mitchsf/Zev/Zev-1.JPG

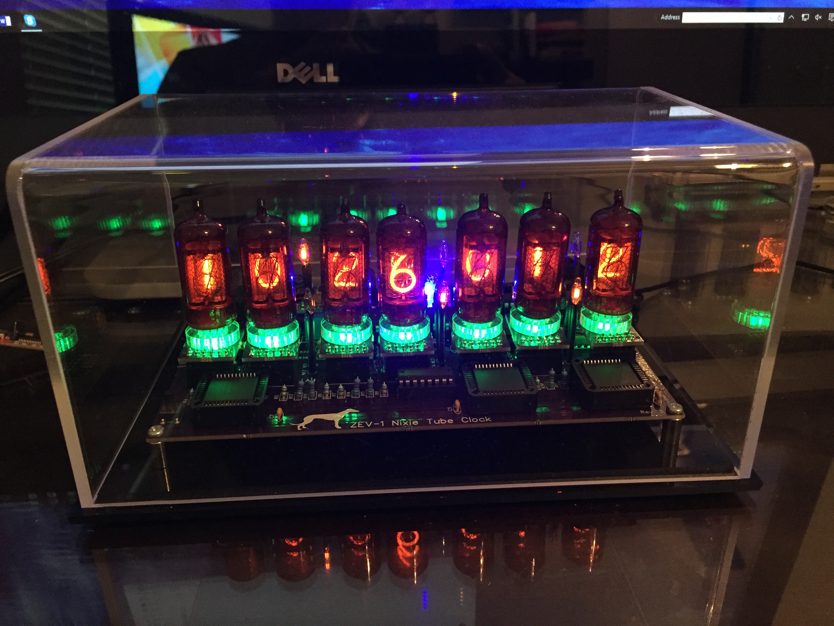
Zev-1.JPG
