mitchsf/Zev/Zev-1-7Schematic.pdf

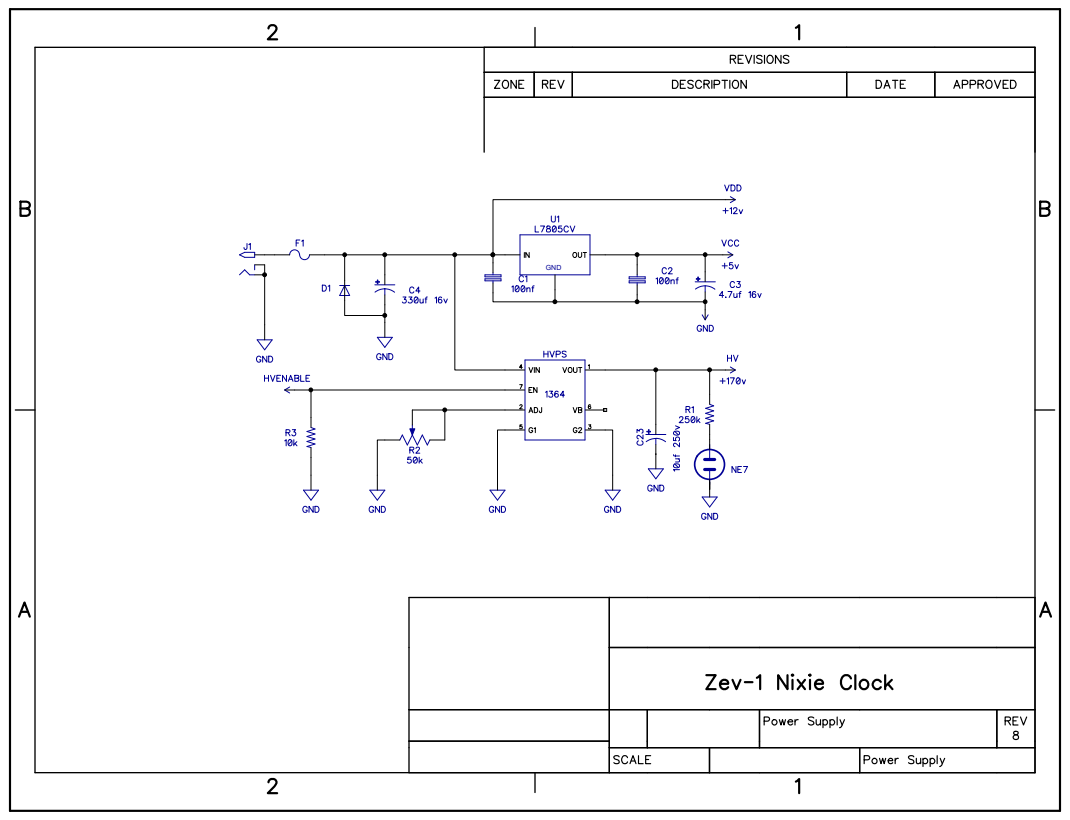
[picture p2: page 1]
GND

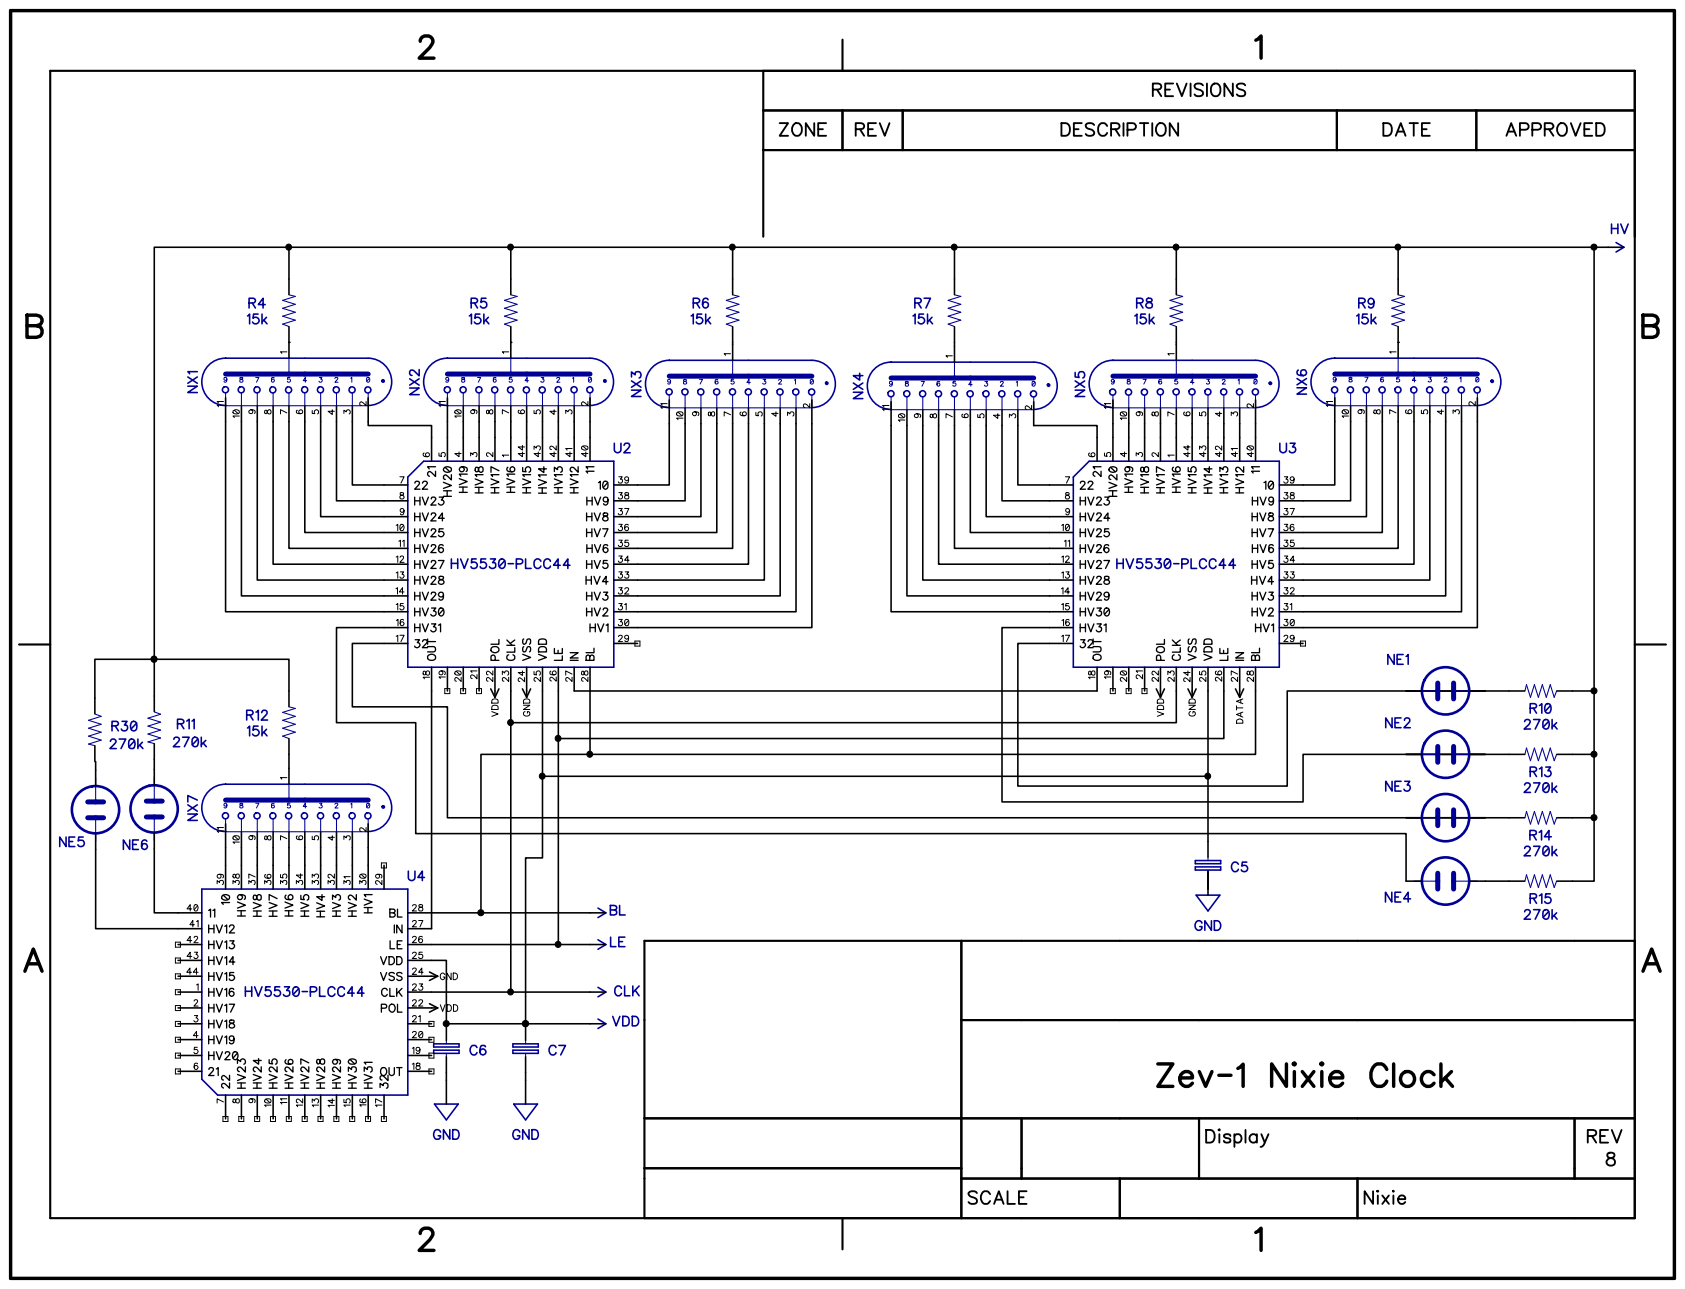
[picture p3: page 2]

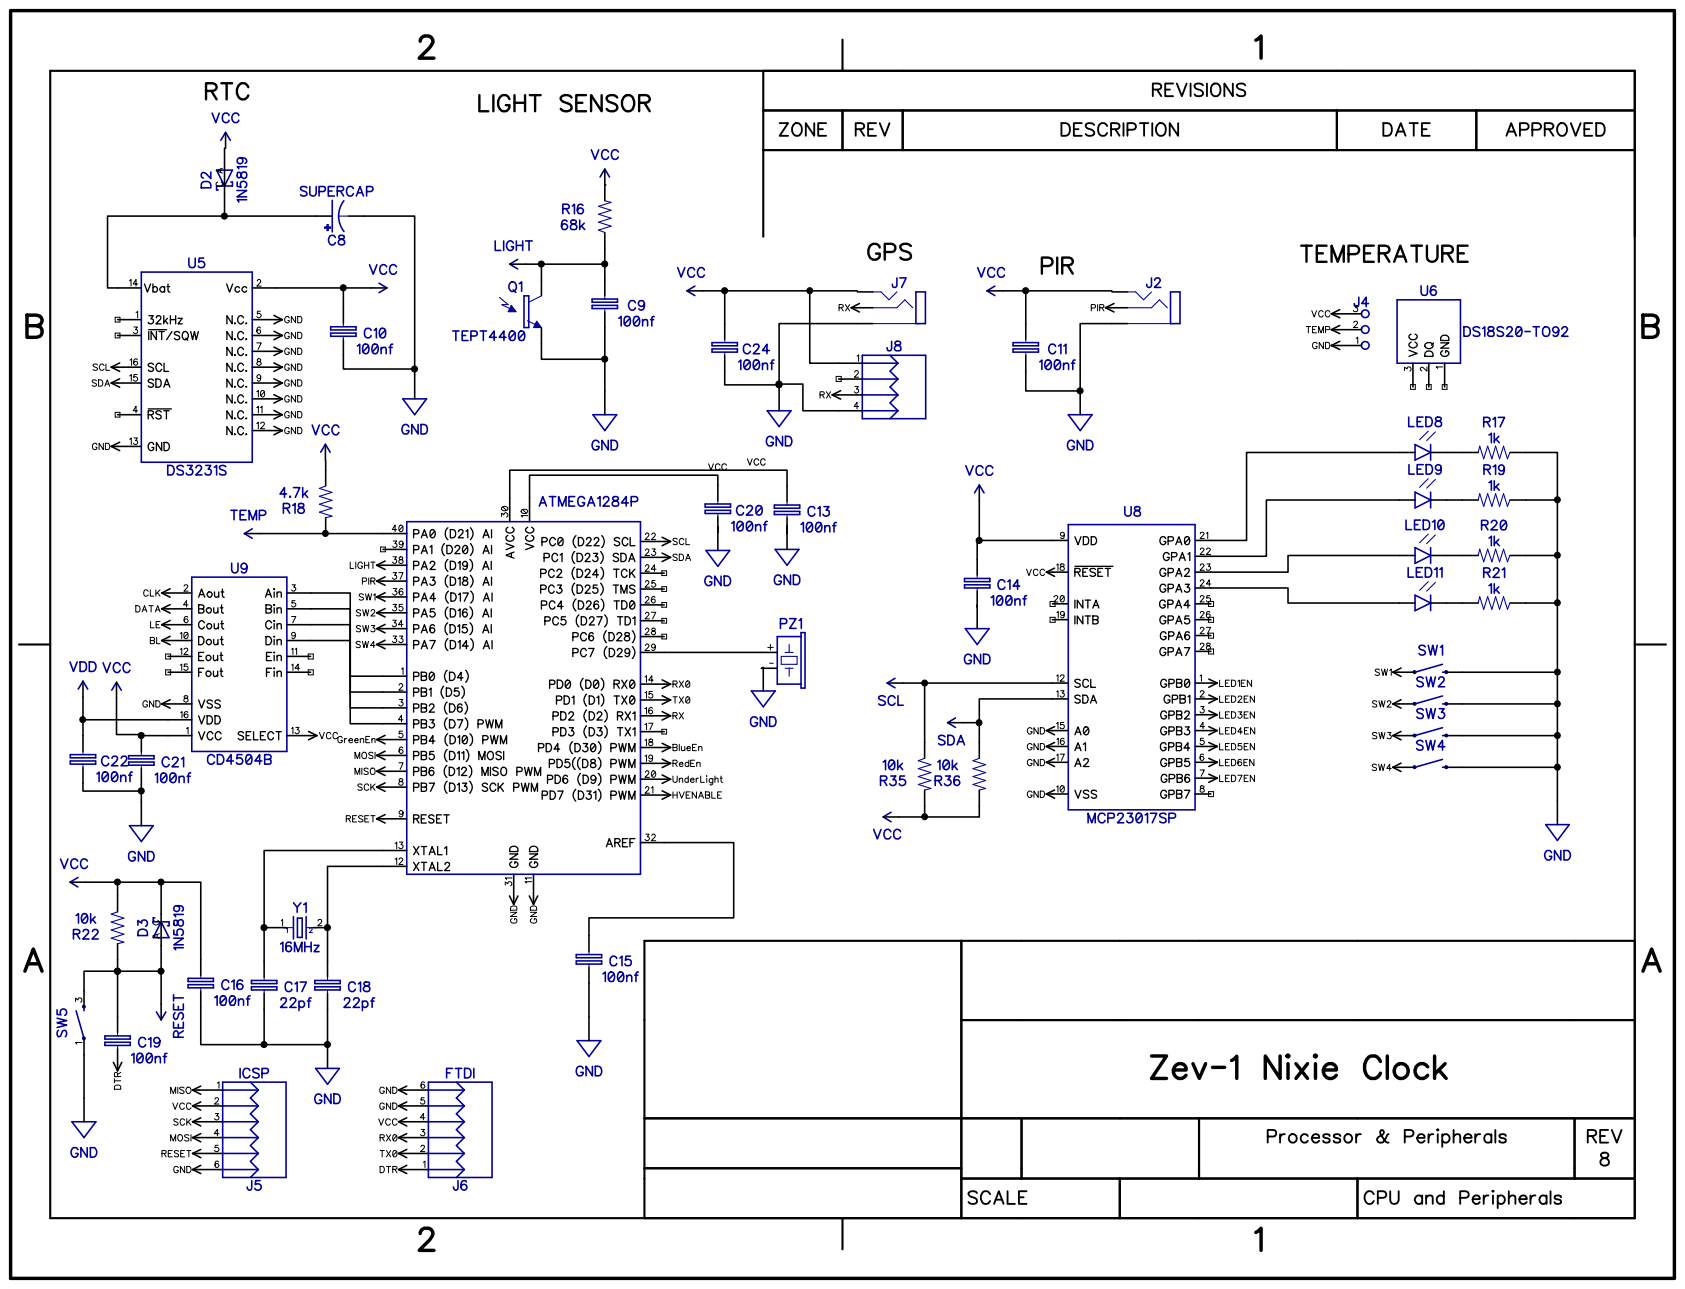
[picture p4: page 3]

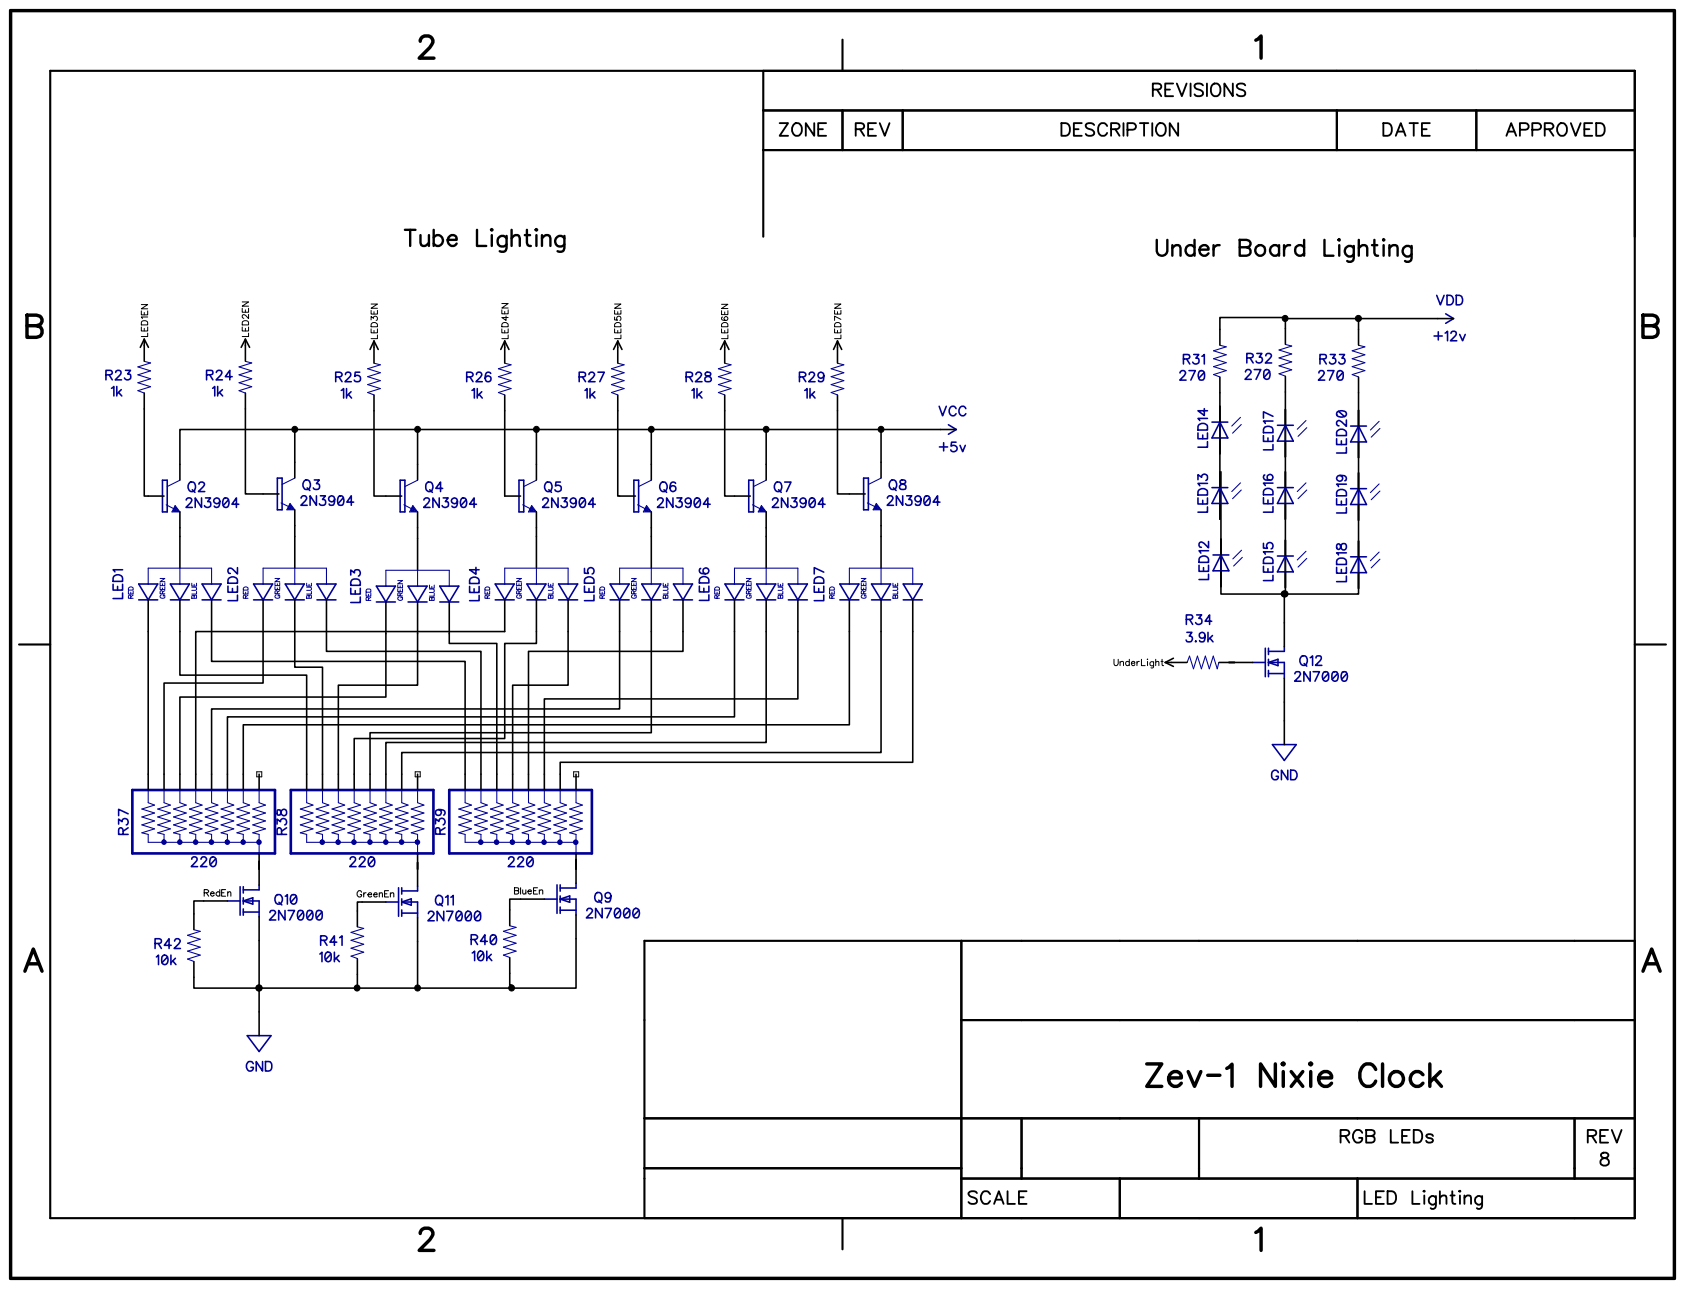
[picture p5: page 4]
