mitchsf/Zev/Zev-1Schematic.pdf

GND

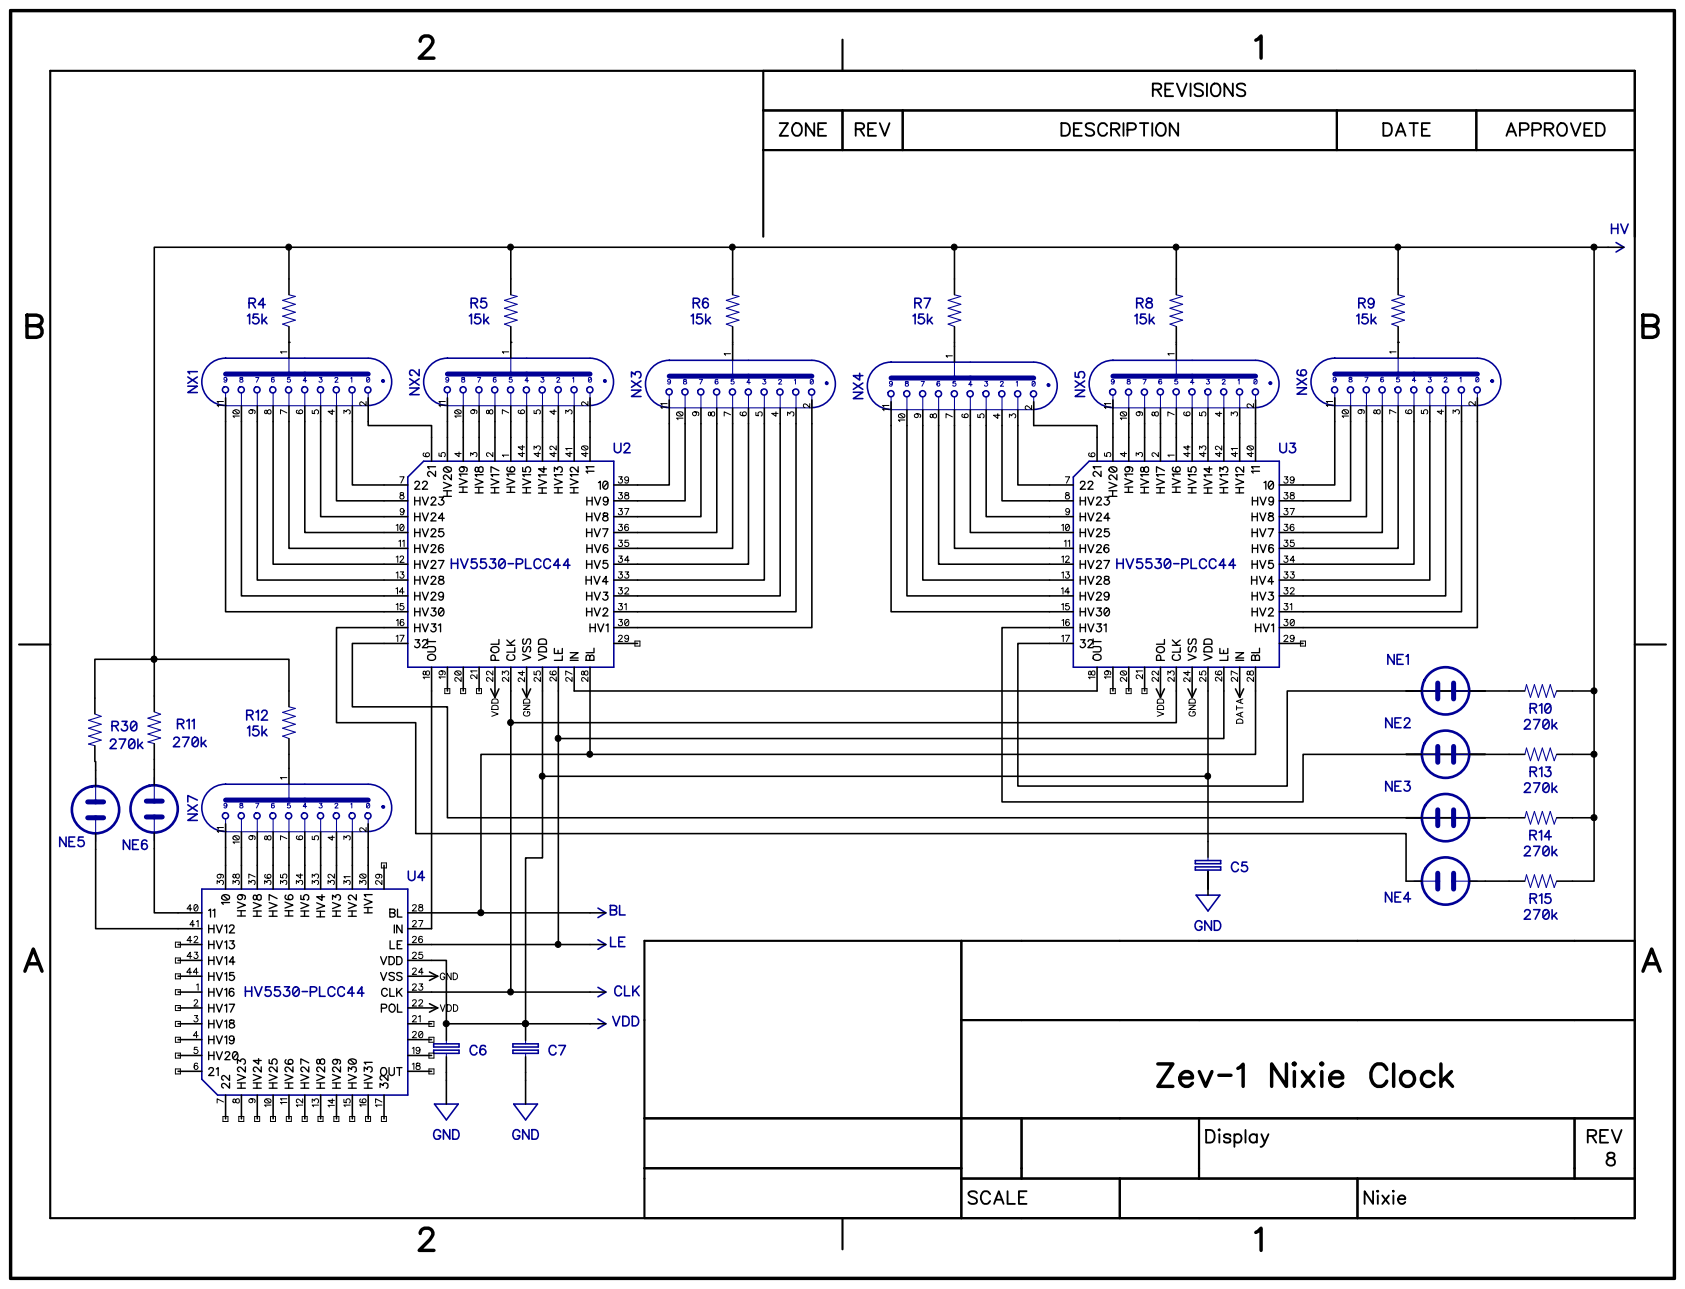
[picture p6: page 2]
