mitchsf/Zev/Zev-1p1.pdf

GND
