mitchsf/Zev/Zev-1-8aSchematic.pdf

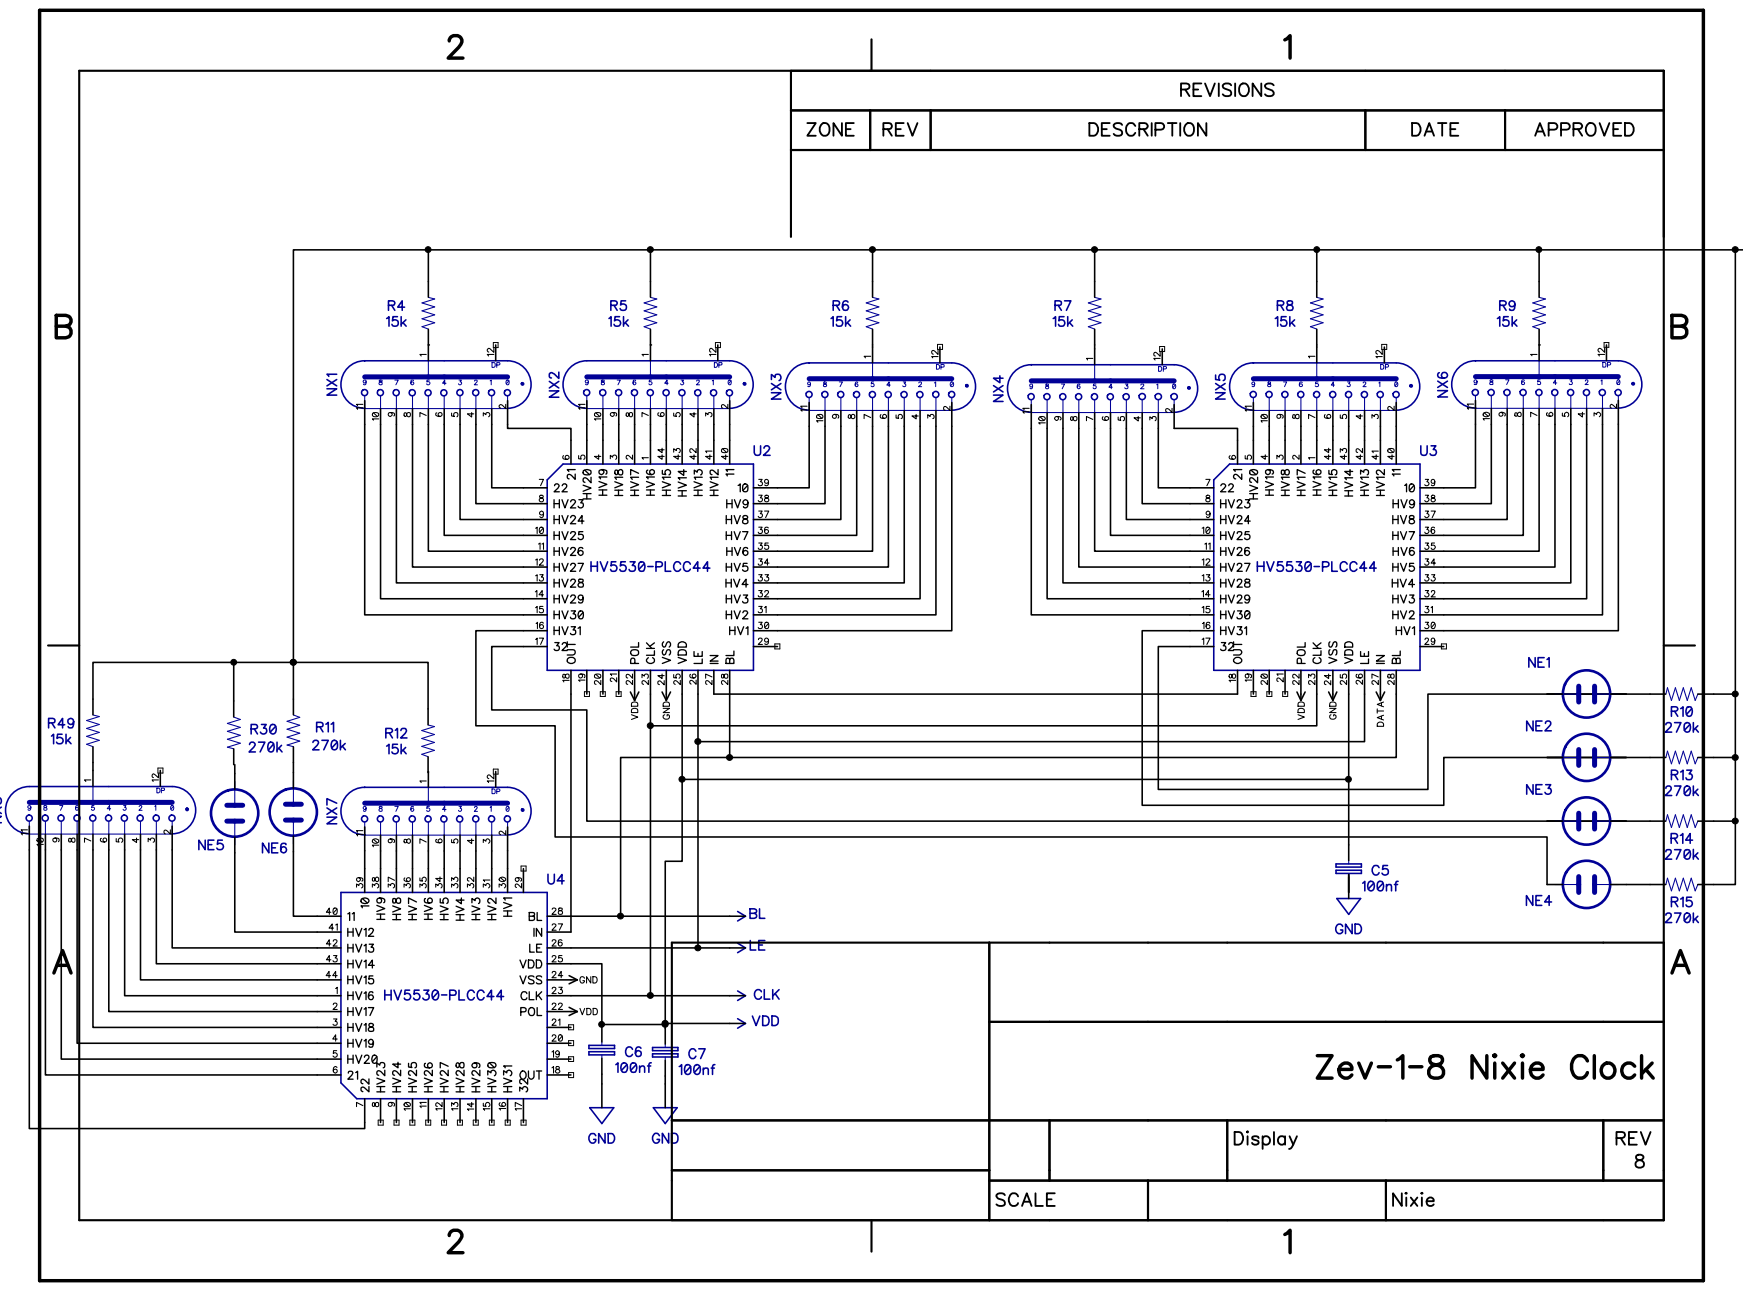
[picture p7: page 1]
