mitchsf/Zev/Zev-1-8bSchematic.pdf

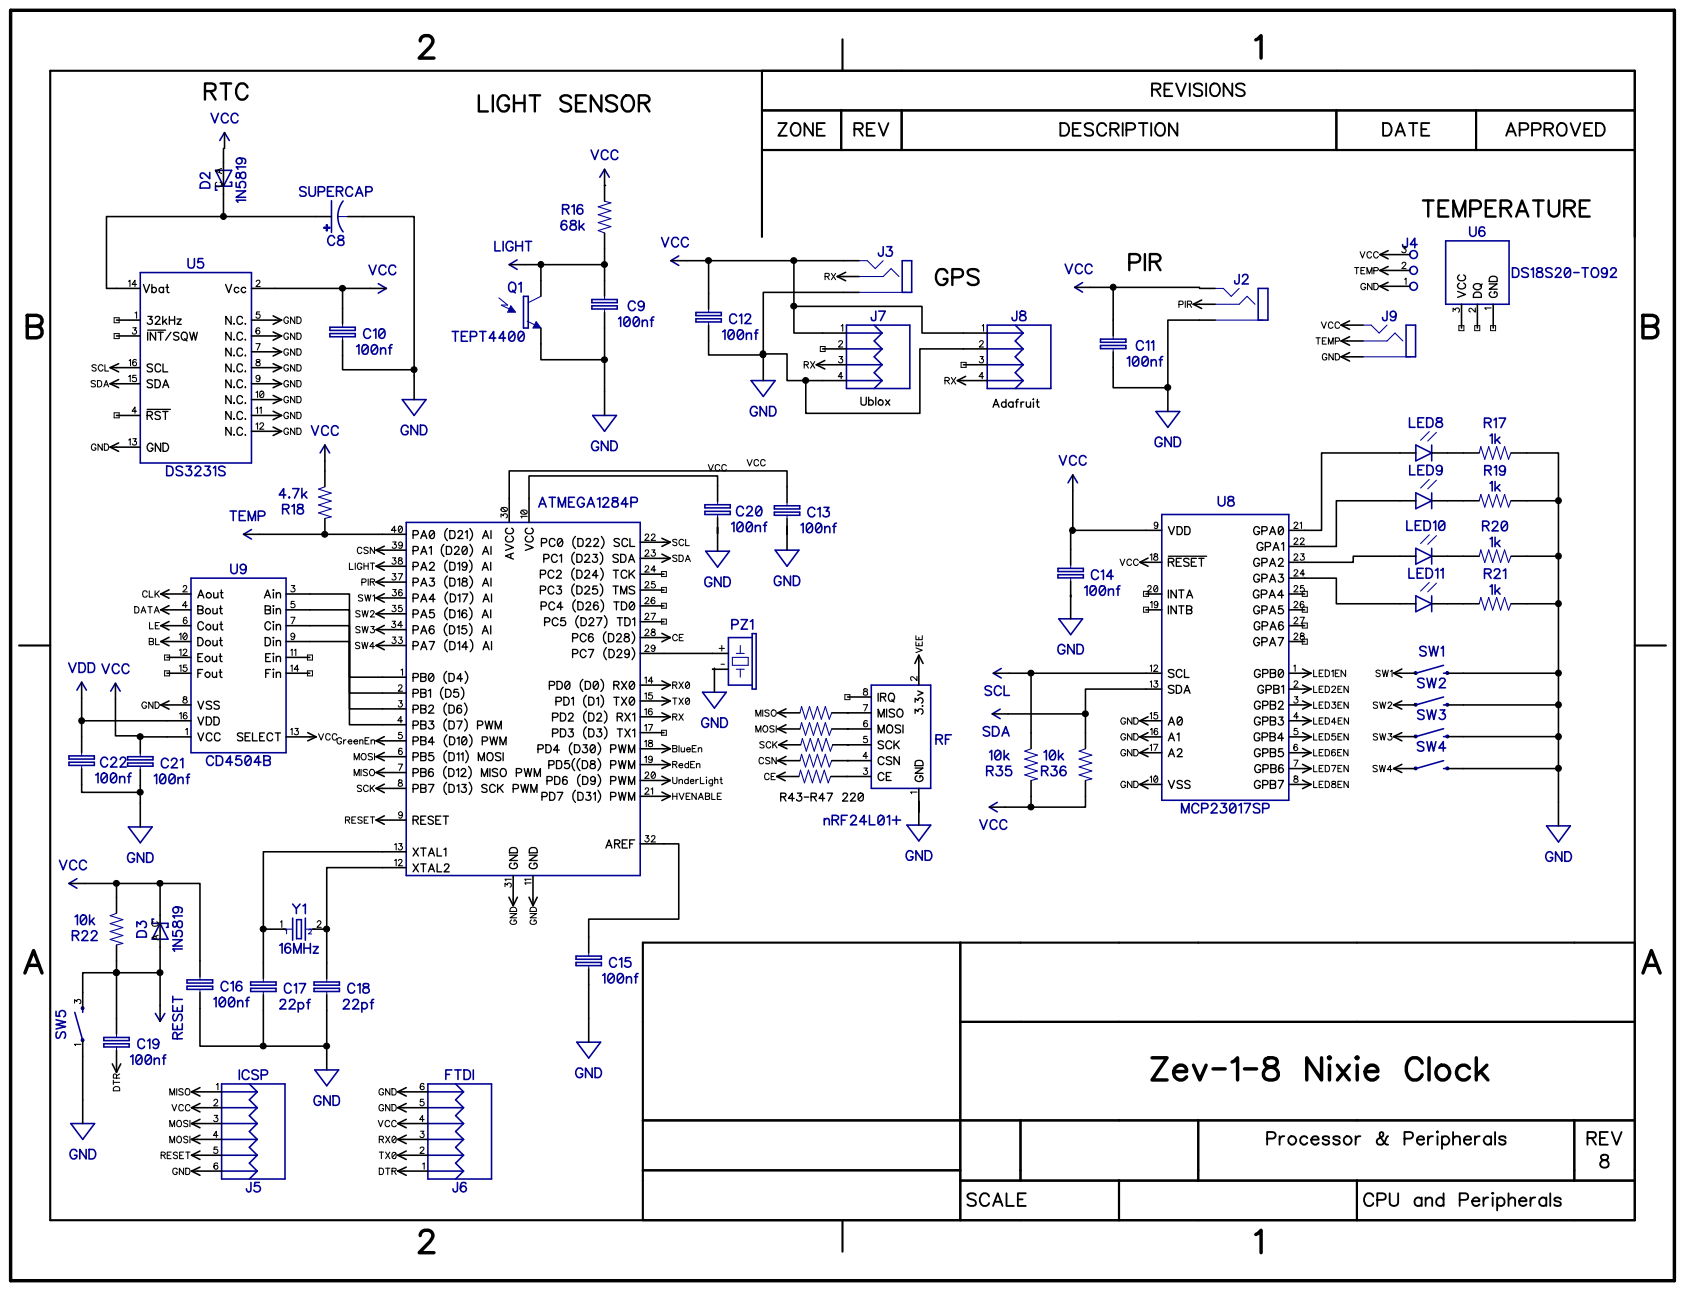
[picture p8: page 1]

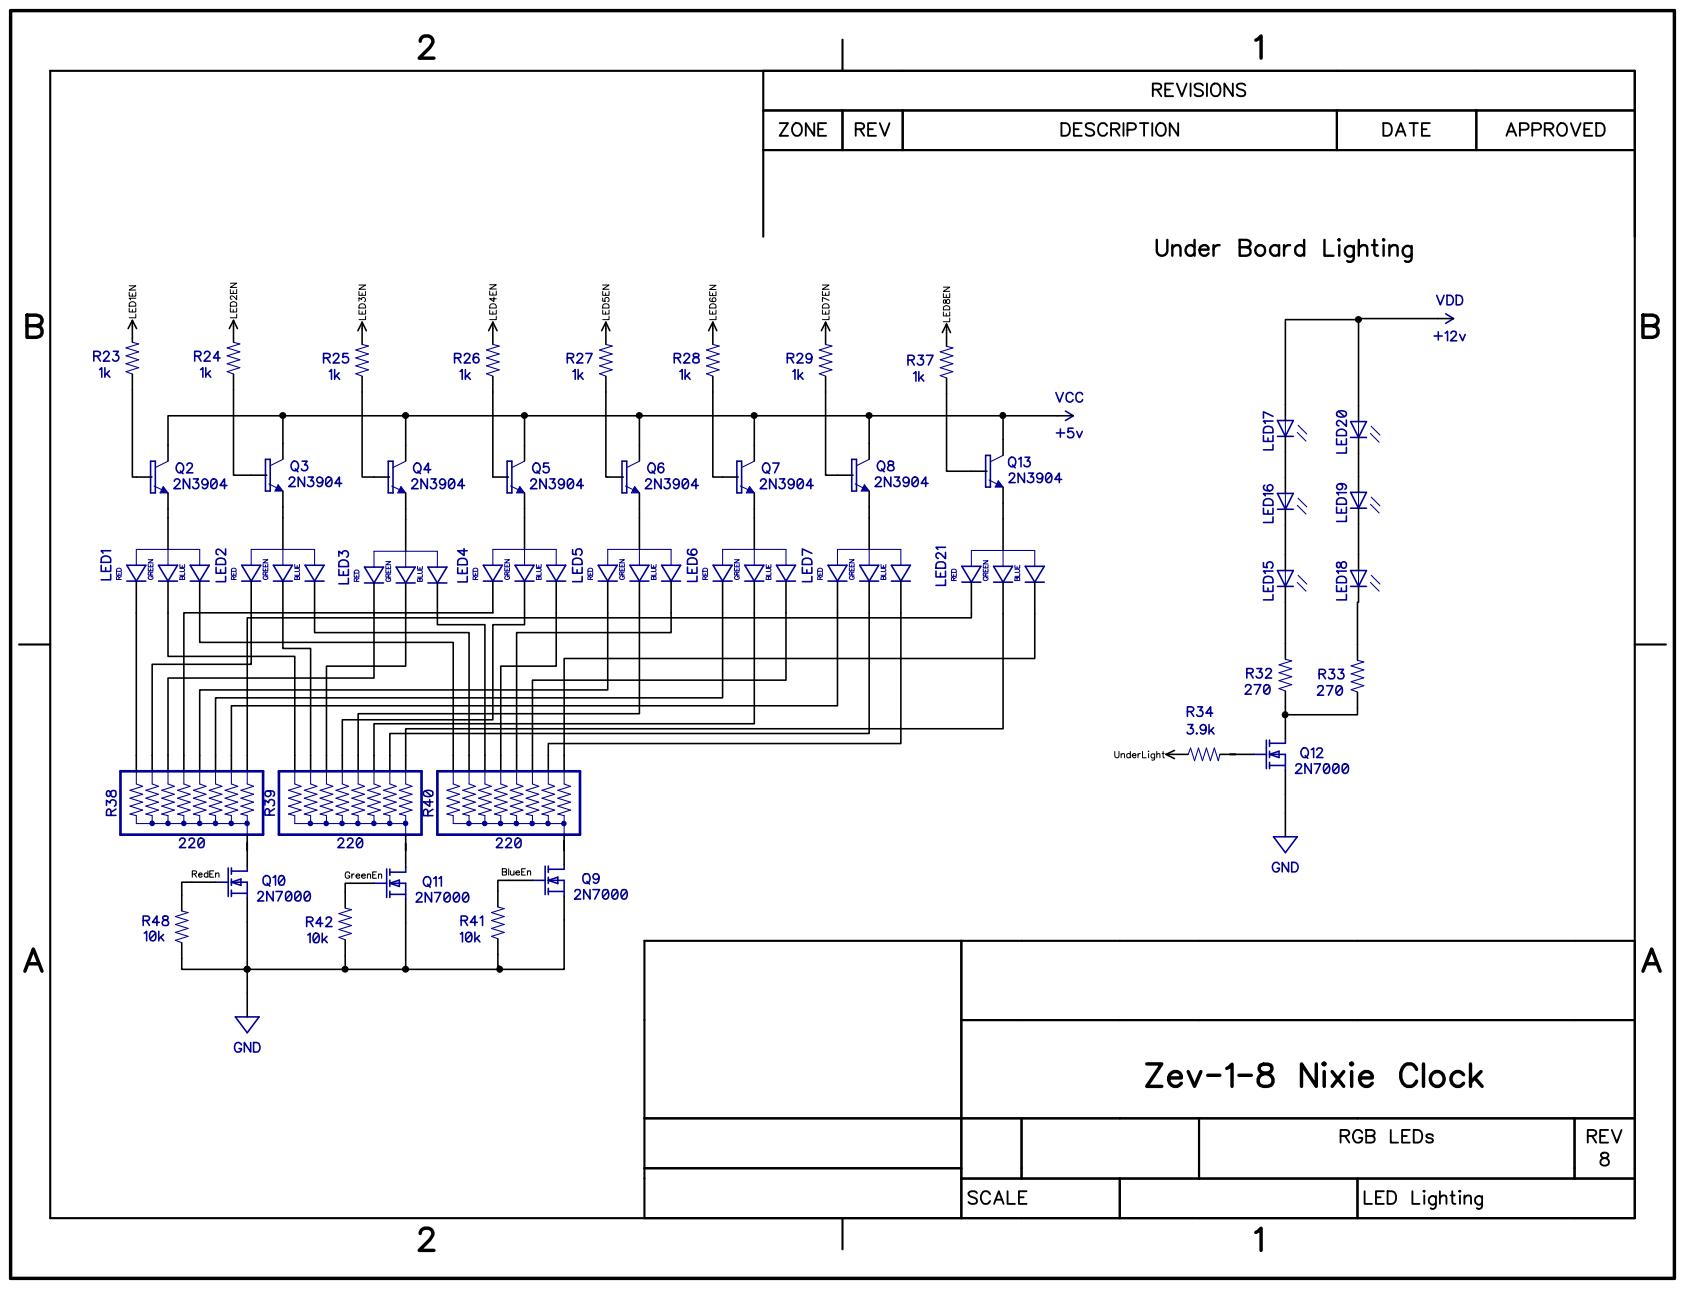
[picture p9: page 2]
