mitchsf/Zev/Zev-1-8Schematic.pdf

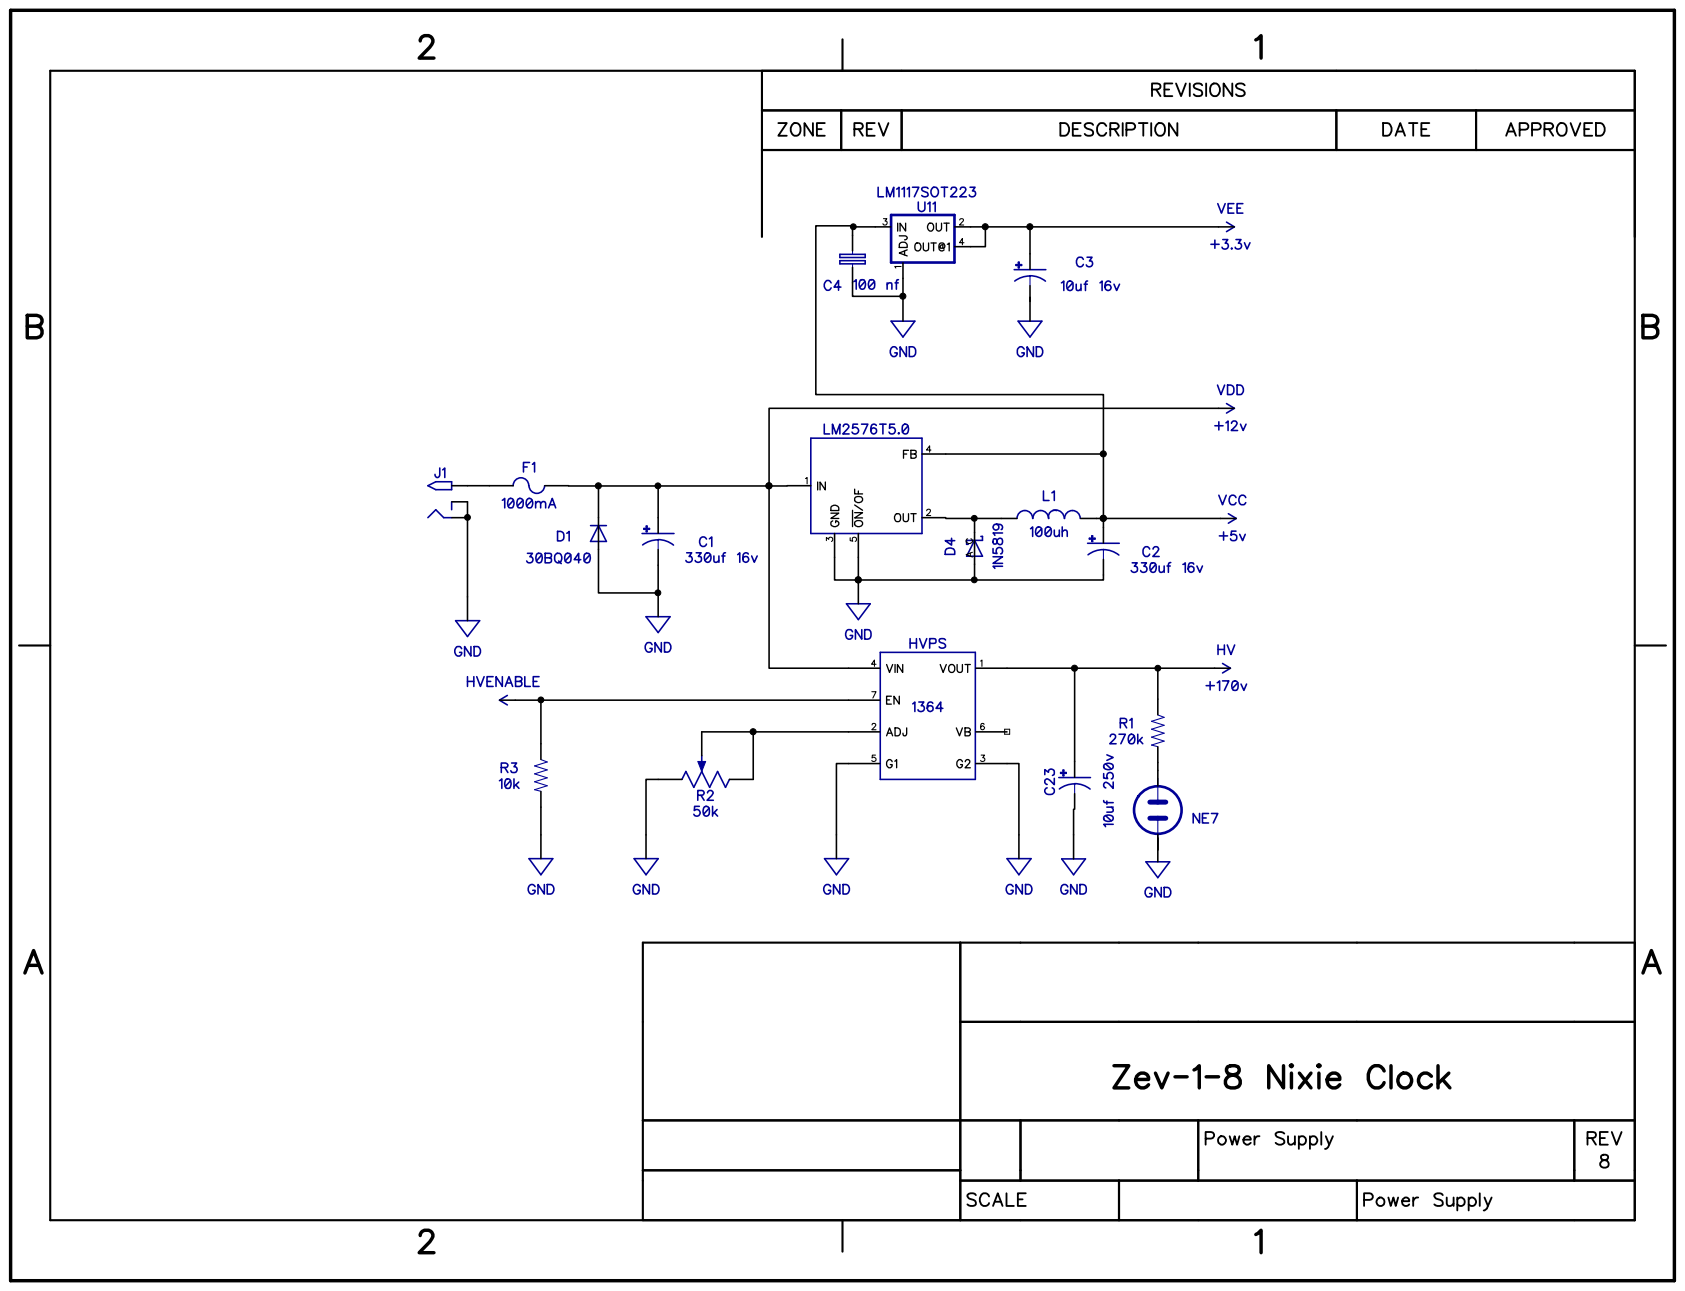
[picture p10: page 1]
