mitchsf/Zev/Zev-2-8aSchematic.pdf

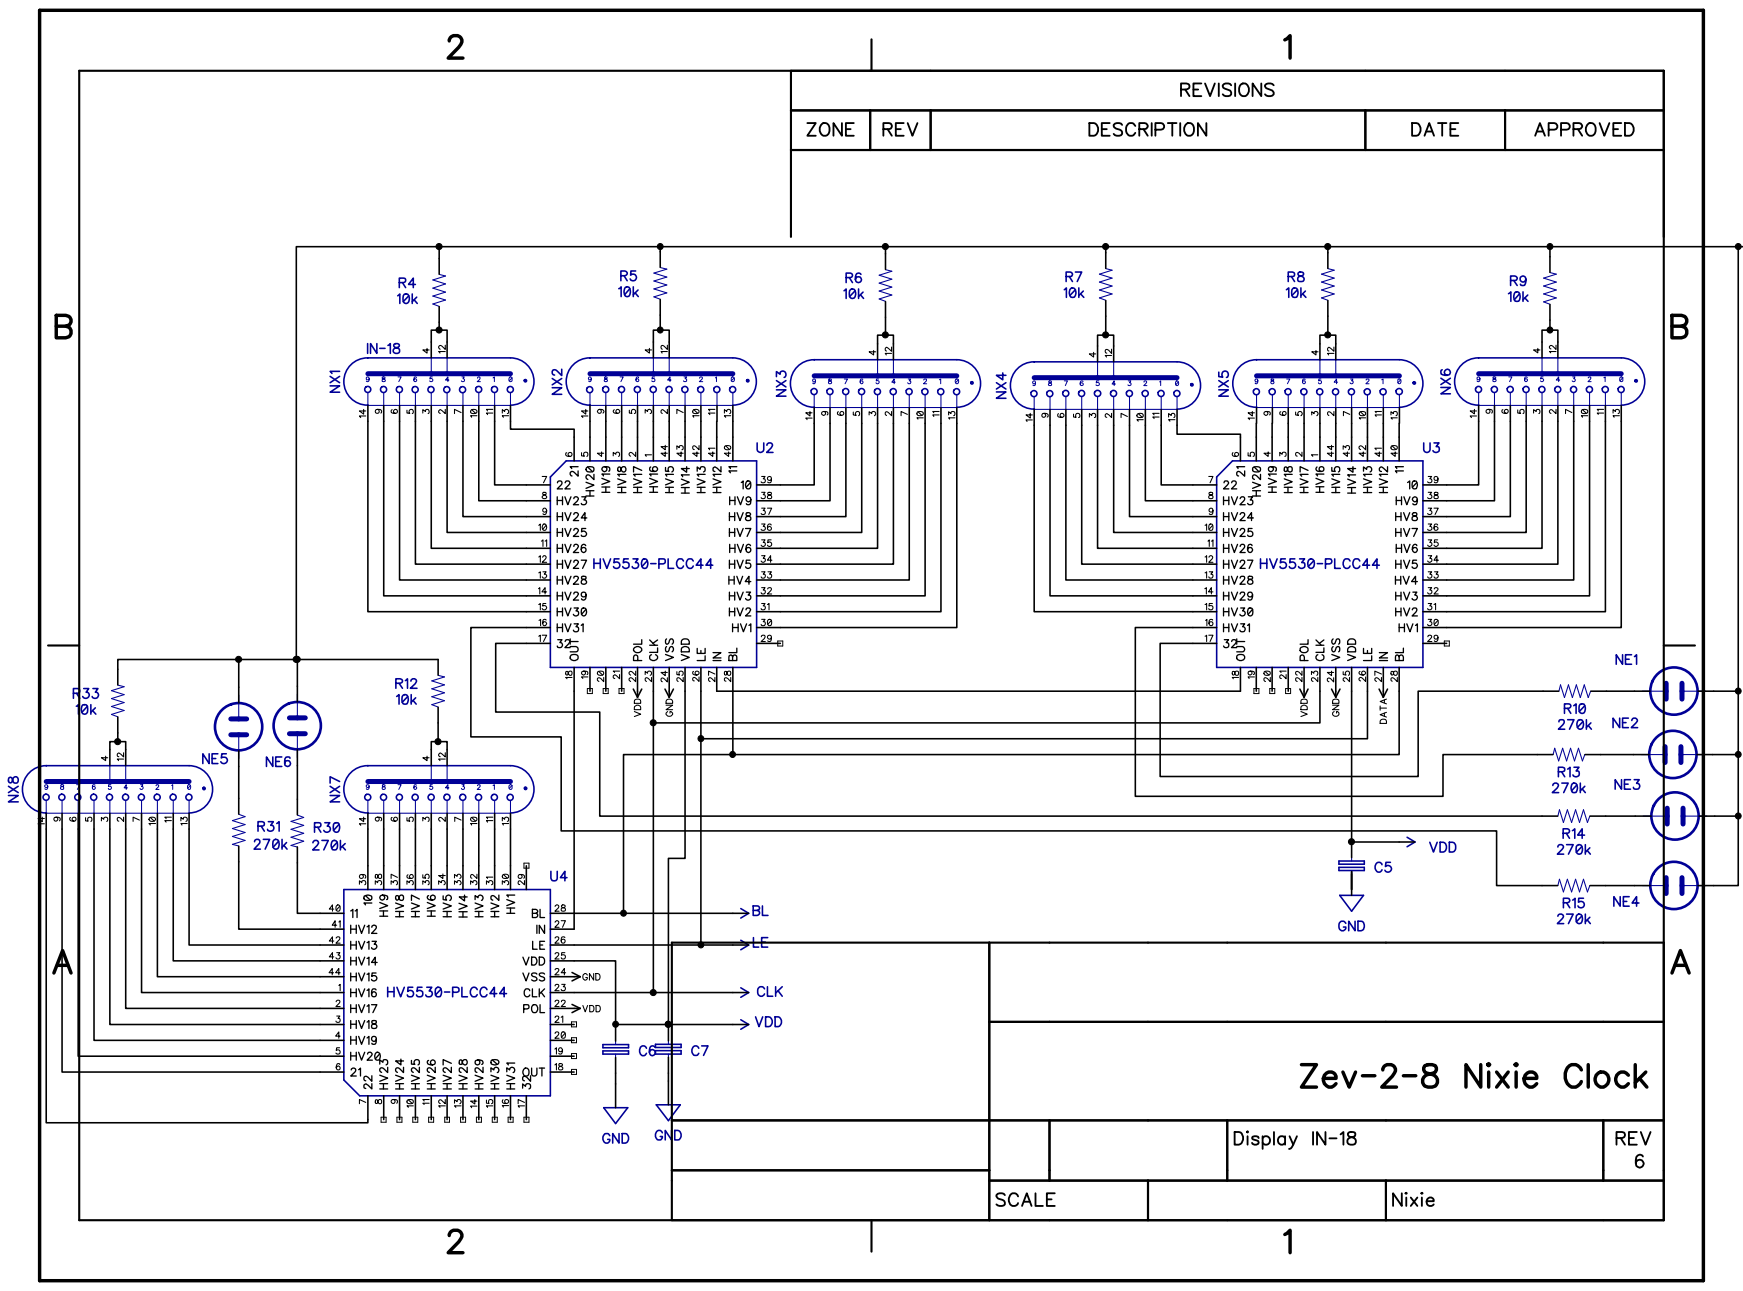
[picture p15: page 1]
