mitchsf/Zev/Zev-2-8bSchematic.pdf

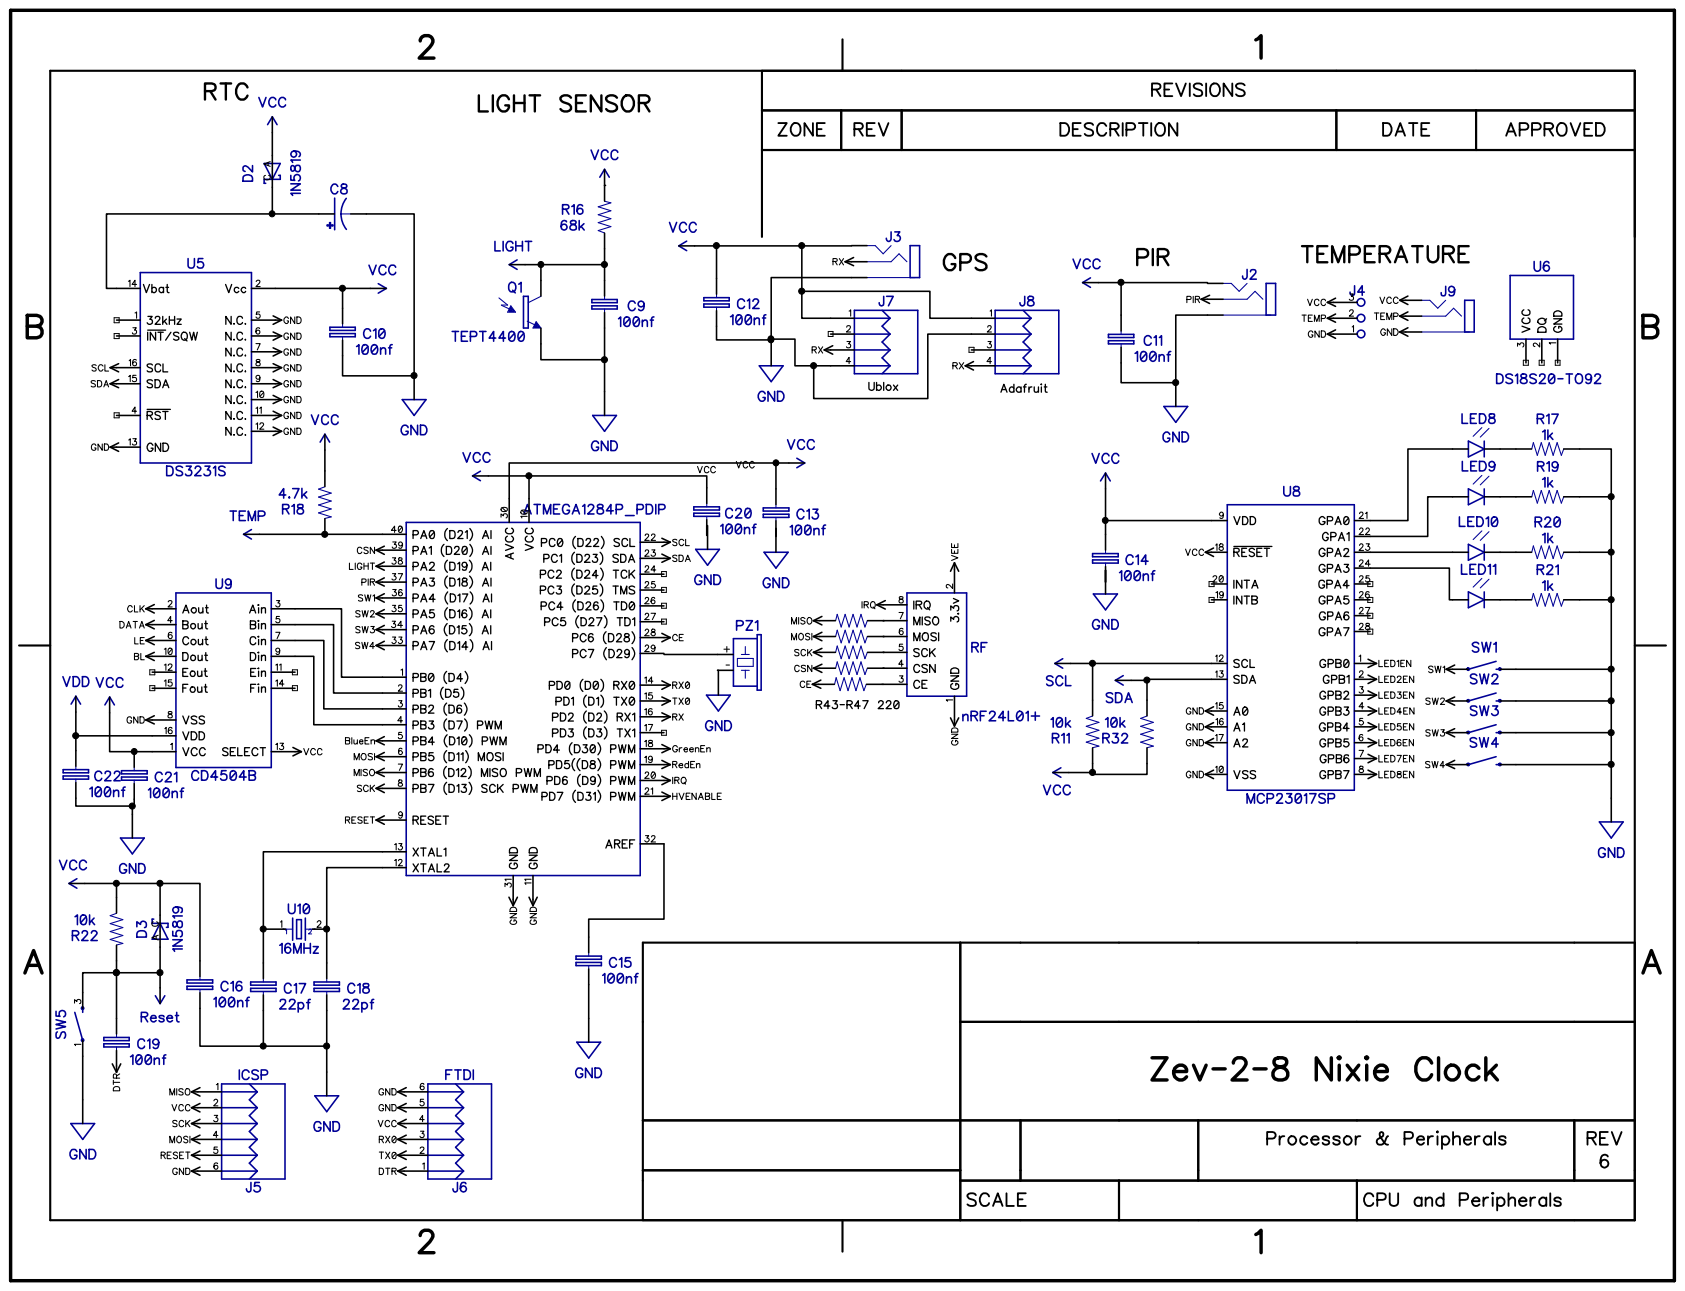
[picture p16: page 1]

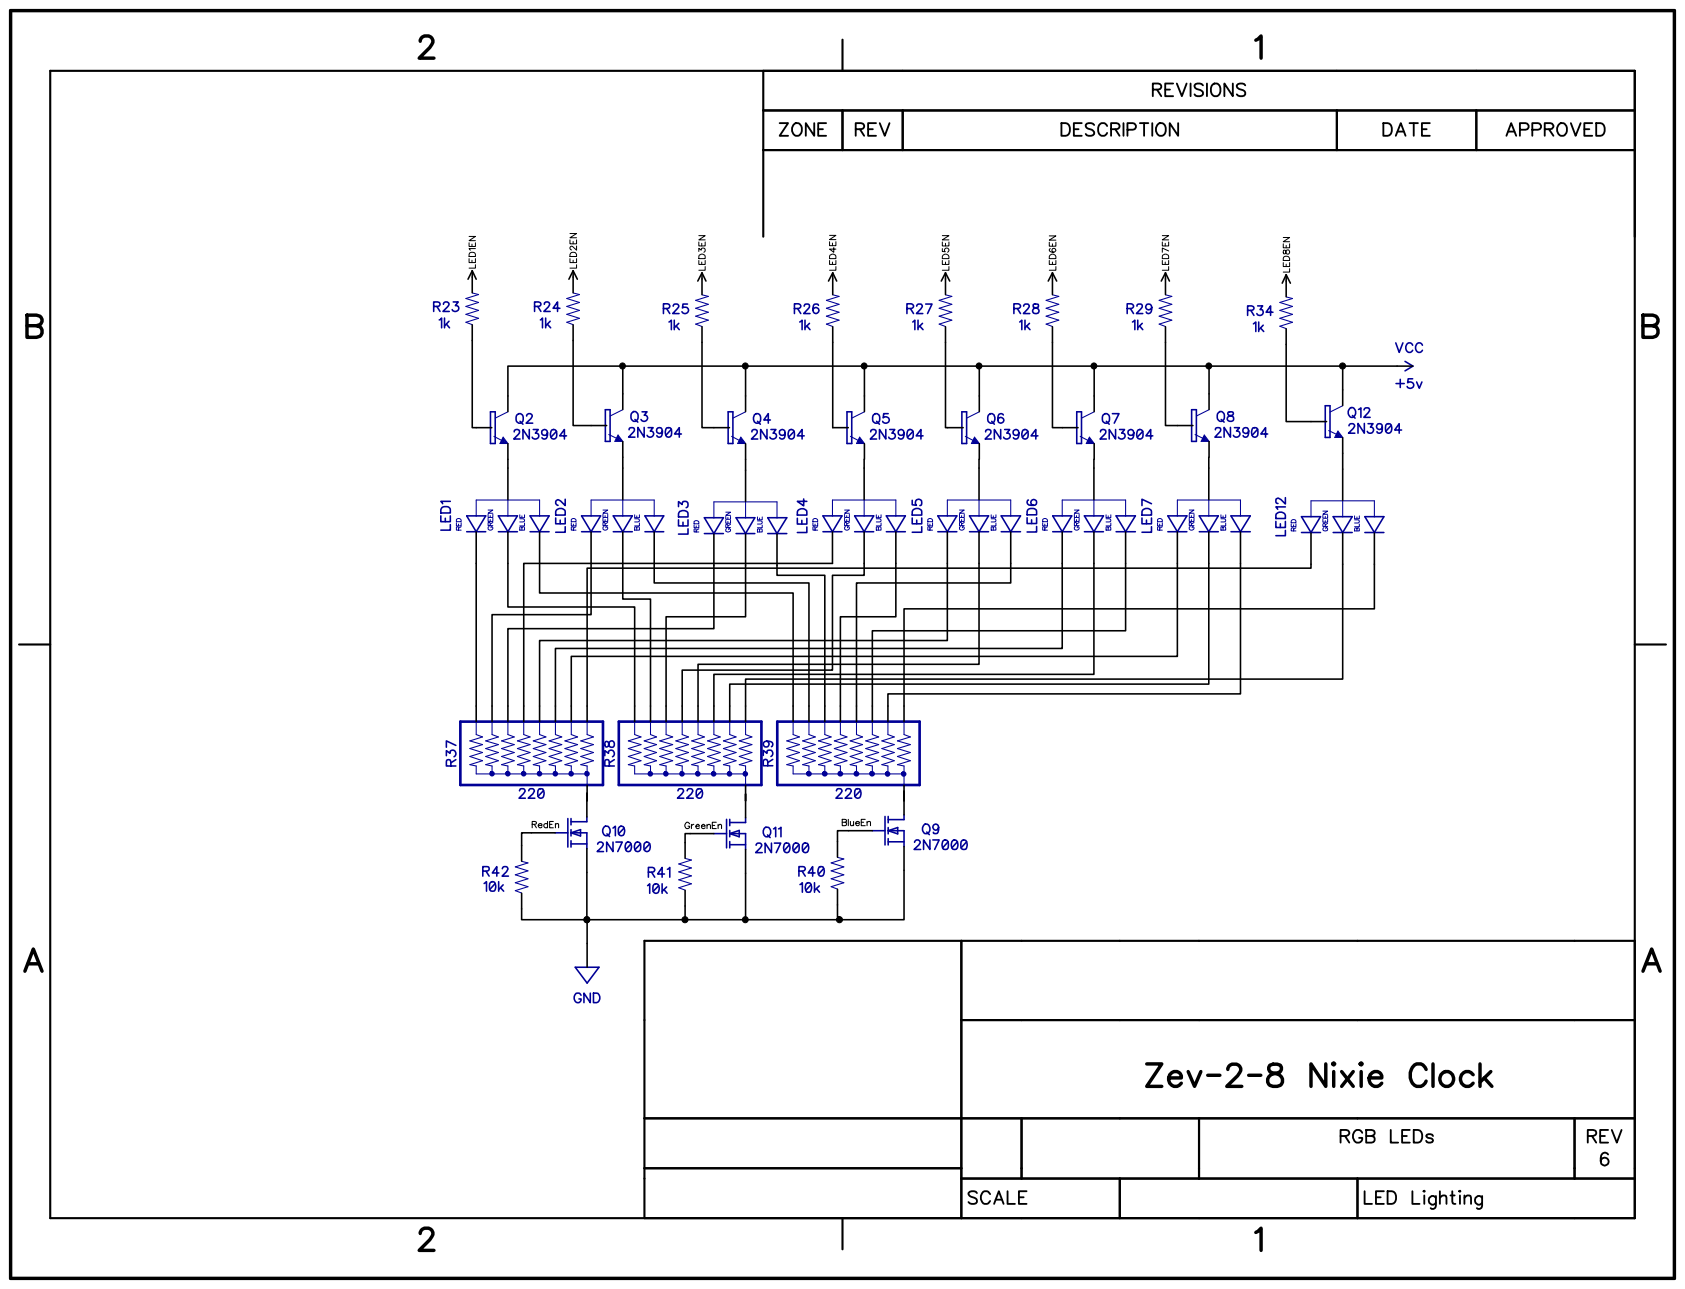
[picture p17: page 2]
