mitchsf/Zev/Zev-2-8Schematic.pdf

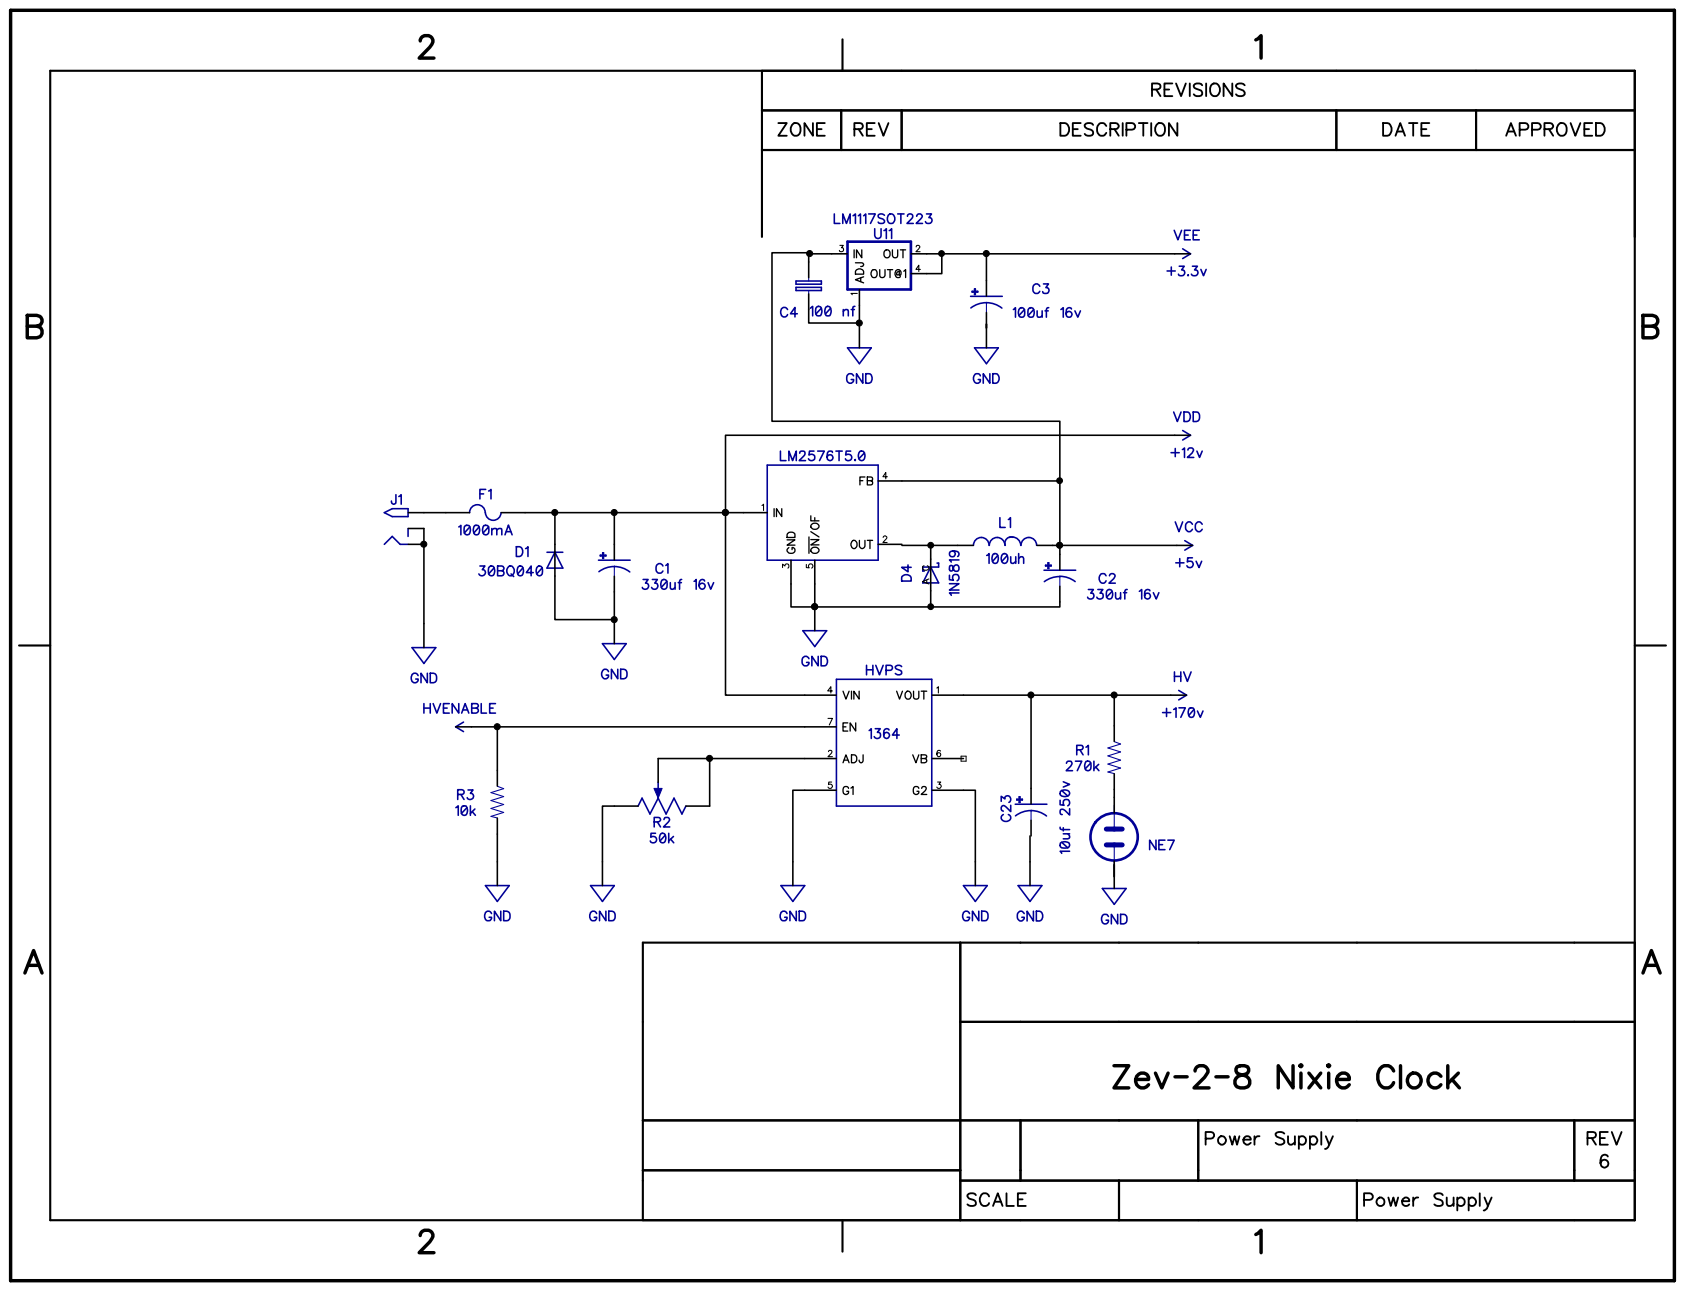
[picture p18: page 1]
