mitchsf/Zev/IN-18sheet.pdf

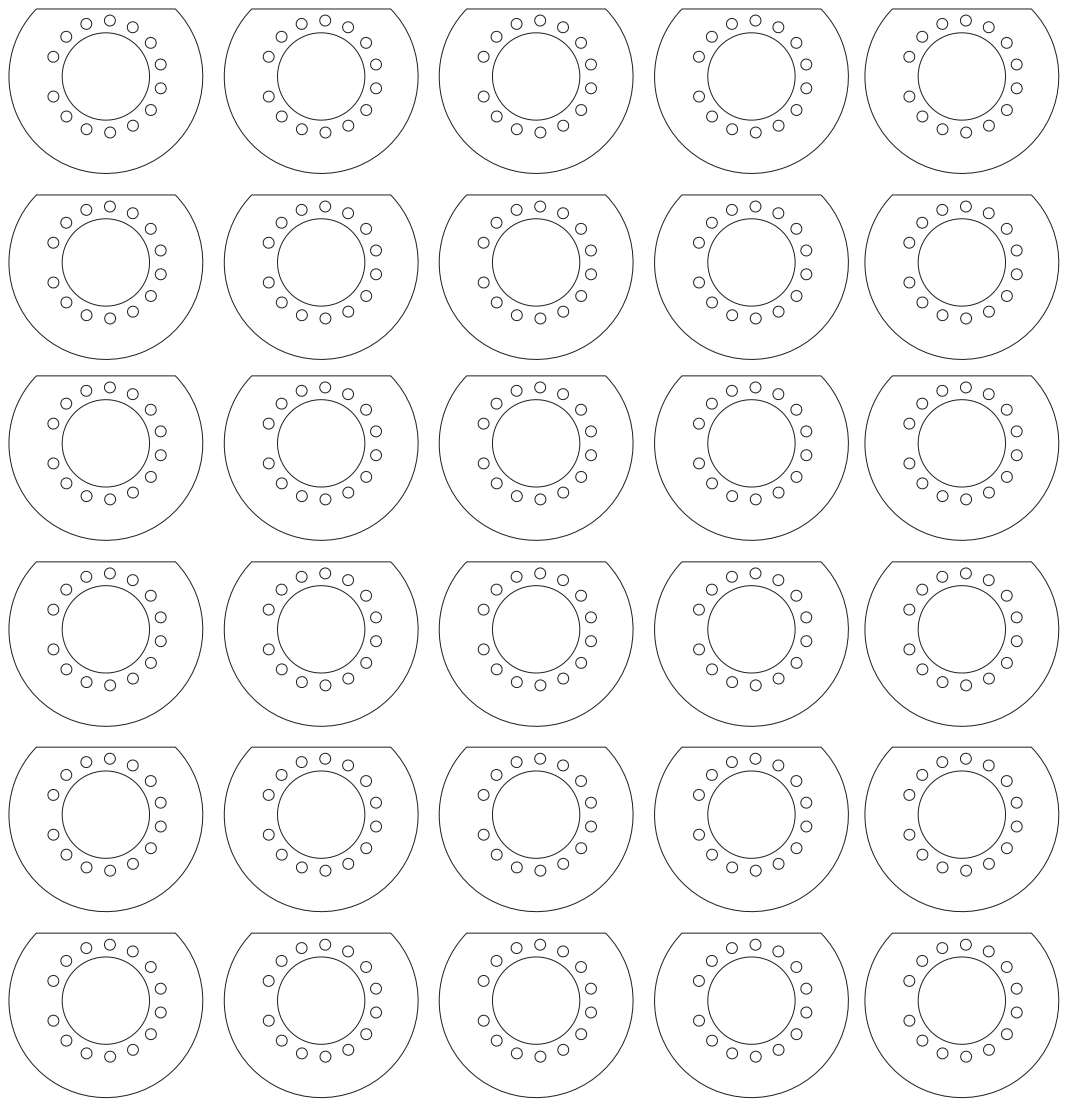
[picture p19: page 1]
