mitchsf/Zev/IN-18single.pdf

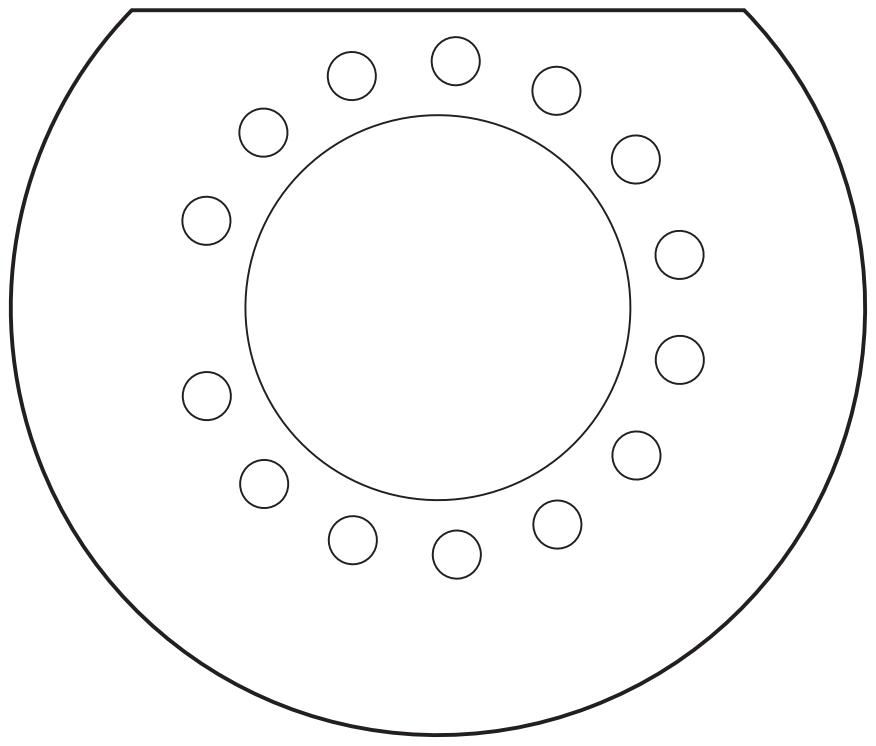
[picture p20: page 1]
