mitchsf/Zev/(list of files, drawings)

Other design files:
IN-8-2.dch
IN-8-2.dip
IN-12B.dch
IN-12B.dip
IN-12BLong.dch
IN-12BLong.dip
IN-14.dch
IN-14.dip
Z570M Series.dch
Z570M Series.dip
Zev-1-8.dch
Zev-1-8.dip
Zev-1.dch
Zev-1.dip
Zev-2-8.dch
Zev-2-8.dip
Zev-2.dch
Zev-2.dip
